Sskki-exe/Bluetooth-Nunchuk-Mouse/README.md

# ESP32-Nunchuk-Mouse #
This repository is for a personal project of mine converting a Wii Nunchuk into a Bluetooth Mouse.

## Controls ##
These are the controls I've configured. The accelerometer is not used. The C button is used for "Change Mode", cycling from 0 to 2. The joystick and Z button will change their behaviour depending on which mode the Nunchuk Mouse is in:  
0. Z button is left click. Joystick will move mouse around.
1. Z button is right click. If Z button is not pressed, joystick will scroll (horizontally and vertically). If Z button is pressed, joystick will move mouse around
2. Z button is middle click. Joystick will move mouse around

## Electronics ##
### Components ###
The inside of the Nunchuk Mouse contains:
* Original circuitry of the Nunchuk
* WROOM32 ESP32 for Bluetooth HID (the chip itself without dev board to save space)
* Custom PCB to mount ESP32 onto
* WEMOS Battery Shield for power and battery management
* 3.7V 250mah 502030 Li-Po battery
* 3.3V Buck Step Down Converter
* Small slide switch

### The Custom PCB ###


The PCB has component holes connected to these pins of the ESP32 WROOM32:

* 3.3V
* GND
* RX (GPIO1)
* TX (GPIO3)
* I2C SCL (GPIO22)
* I2C SDA (GPIO21)

3.3V and GND are required for powering the ESP32. RX and TX are required for programming. The I2C pins are required for reading data from the Nunchuk.
The PCB also have pullup resistors and buttons for Enable and Boot (GPIO0). Do not forget these if you choose to design your own PCB.

#### Pullup Resistors ####
For those who don't know what they are.
* A pullup resistor is a resistor connecting a pin (such as Enable) to high (3.3V)
* A button is connected to the same pin and ground
* Normally, the current flows from high, through the resistor, to the pin
* When the button is pressed, the current flows from high, through the resistor, to ground (path of least resistance)
If a button is just connected to high and a pin, when the button is not pressed, it "floating". This means pin may not be at ground voltage because of random electromagnetic waves in the air (from radios etc.) which may confuse a circuit into thinking the button was pressed. By using a pullup resistor, when the button is not pressed, the pin is "pulled up" to 3.3V while when the button is pressed, it is connected directly to ground so the pin is never floating.

### The Circuitry ###
#### Nunchuk to ESP32 ####
The circuitry of the Nunchuk remain unchanged, the cable is cut off and connected to the ESP32. If your Nunchuk is not genuine, the colors may be different so go by their position on the connector.

Nunchuk Pinout

Nunchuk      | Position on Nunchuk | ESP32
------------ | ------------------- | ----------------
White (GND)  | 4 Bottom Left       | GND
Green (SDA)  | 1 Top Left          | I2C SDA (GPIO21)
Yellow (SCL) | 6 Bottom Right      | I2C SCL (GPIO22)
Red (3V3)    | 3 Top Right         | 3.3V

#### Power Management ####
The power management board may need trimming:
* The battery connector was desoldered, the battery was soldered onto it directly
* The USB micro port was removed, the leads were extended and a new micro port can be soldered and positioned in the cable hole of the Nunchuk. I got a magnetic USB charging cable (for phones), mangled the phone side plug part to get to the tiny pcb inside and soldered it to the power management board. There's a magnetic connector at the bottom of my Nunchuck which is neat.
* The GPIO holes that aren't used as well as where the batter connector used to be can be Dremeled off at your own risk

The wiring for the power management is pretty straight forward:
WEMOS Battery Shield | Battery         | Buck Down Converter | ESP32
-------------------- | --------------- | ------------------- | -----
Battery Positive (+) | The red one duh | .                   | .
Battery Negative (-) | The black one   | .                   | .
5V (the GPIO one)    | .               | Input +             | .
GND (also GPIO one)  | .               | Input -             | .
.                    | .               | Output +            | 3.3V
.                    | .               | Output -            | GND

## Programming the ESP32 ##
You can search for tutorials on how to use an FTDI to Serial converter to program it. I ordered a chip by itself from Aliexpress and I experienced a lot of frustration until I realised the chip was dead. The easiest way to program the ESP32 is to use a dev board. This takes a bit of finessing.
* Connect 3.3V, GND, RX and TX pins of the dev board to the custom PCB
* Hold down enable and boot button of the dev board
* Hit compile and upload on the Arduino IDE
* Hold down boot on the custom PCB then click enable (also on the custom PCB) once
* When it starts to upload, you can let go of the custom PCB's buttons
What I also did was I actually got my ESP32 from the dev board. I tried to desolder it using solder wick but there's a patch of solder holding the ESP32 that holds it down. I slid a knife underneath it and cut it off (do this at your own risk). I then pryed off the enable and boot buttons from the dev board and soldered wires in their place (so they're always being presssed down). I then soldered wires to the appropriate GPIO pins of the dev board with spring hook probes on the end. This let me easily hook onto the component holes on the custom PCB without soldering on headers which would've taken up space.

## Assembly ##
**You will require a tri-wing screwdriver** to open genuine Wii Nunchuks, don't even bother trying to open it up without one. I got one off Aliexpress for like 5 bucks. Otherwise, third party or bootleg Nunchuks will probably have Phillips heads (I absolutely despise Henry Ford for popularising this garbage screw head).
1. Open up the Nunchuk
2. Cut the cord off, leaving enough colored wires coming from the PCB to connect to the ESP32 (use a multimeter to check which wire is which if you're not using a genuine Wii Nunchuk
3. Use a knife and pliers (or a Dremel if you're extra brave) to cut off the plastic webbing (walls) inside but leave the screw posts intact if you plan to screw it back together (I mean you *can* always glue it back together but do you really want to commit to never modifying your code?). I would recommend leaving all the plastic that goes around the joystick for rigidity.
4. Trim any of the components that will go inside the Nunchuk at your own risk, try not to break any connections you need.
5. Cut a rectangular hole in the side of the Nunchuk for the switch to stick out of. There's a perfect spot under the joystick towards the sides of the Nunchuck where there's two webbed parts that a slide switch can fit into. As there are wires running around the left side of the joystick chassis, choose the right side. You will also need to:
  - Cut the chassis thing that the joystick is attached to
  - file down the pins and solder of the y-axis potentiometer of the joystick
  - Insulate the bottom of the y-axis potentiometer (you don't know how much time I spent wondering why my Nunchuk kept drifting because it was shorting on the switch). I recommend using liquid electrical tape but I made do with a dab of hotglue, flattening it with a small piece of tape, then remove the tape.
7. If your wiring is functional, check that the components fit inside the Nunchuk and make sure that the wires are not too short or long.
8. I recommend hot gluing the switch in its position (probably don't glue it down permanently)
9. Stuff everything in and screw it together

## Code ##
The Arduino code uses [W-vK's ESP32-BLE-Mouse Library](https://github.com/T-vK/ESP32-BLE-Mouse) and [Robert Eisele's Nunchuk Library](https://github.com/infusion/Fritzing/tree/master/Nunchuk). The ESP32-BLE-Mouse library can be installed as a zip file while the Nunchuk library is a .h file that needs to be included in the same folder as the .ino file. You will need to calibrate it and you can optionally customise the Bluetooth information.
### Calibration ###
The Nunchuk is not perfect and requires calibrations of deadzones and limits. Modify the code to your specific Nunchuk. Write a program that prints the Nunchuk joystick values to serial (you can ask me for help if you have no idea how to do that).
#### Deadzones ####
Leave your joystick in the "neutral position". The lowest and highest values for each axis are the low and high bounds of the deadzones.
Variable Name | Full Name
------------- | ----------------------------------
xDzL          | x axis deadzone lower bound
xDzH          | x axis deadzone higher/upper bound
yDzL          | y axis deadzone lower bound
yDzH          | y axis deadzone higher/upper bound
#### Physical Limits of Joystick ####
Push your joystick to each extreme (push it all the way left, right, up and down). The lowest and highest values for each axis are the low and high bounds of the x and y axes.
Variable Name | Full Name
------------- | -----------------------
xLow          | minimum x value
xHigh         | maximum x value
yLow          | minimum y value
yHigh         | maximum y value
#### Moving & Scrolling Speeds ###
This one is going to be trial and error. Change these values, upload to your Nunchuk Mouse, try it out and repeat until you're satisfied. I think these values should be fine for most people. As I implemented my code, the values must be integers so if you want finer adjustments, you'll have to edit the code.
Variable Name | Full Name
------------- | -----------------------
mSped         | move speed
sSped         | scroll speed
### Changing the Bluetooth Information ###
You can rename the name, manufacturer and batter level shown for the Nunchuk by changing the parameters in line 4 of code. 
* Replace "Nunchuk Mouse" with the device name you want to show up on your computer/etc.
* Replace "Sskki" with the manufacturuer name you want.
* Replace 69 with whatever battery percentage you want to show up on your computer/etc. because battery monitoring was not wired up.
```arduino
BleMouse bleMouse("Nunchuk Mouse","Sskki",69);
```
