Sskki-exe/Bluetooth-Nunchuk-Mouse/PCB/silk.png

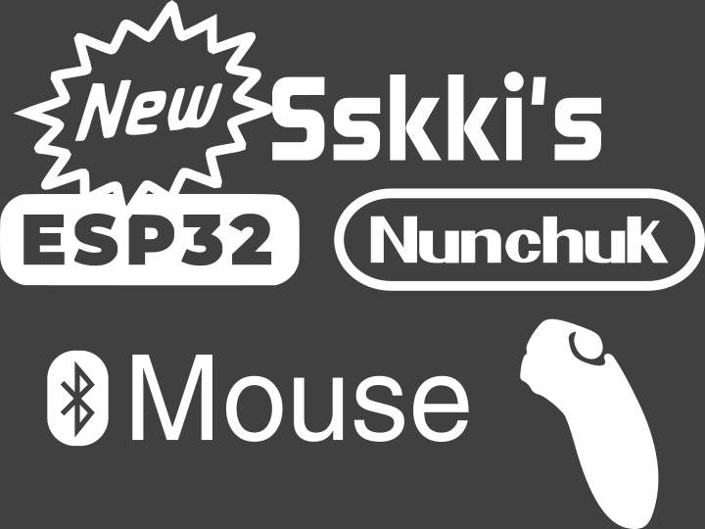
PCB/silk.png
